nitin710/openplant_incubator_ee/3d/ATX_Connector_24pi_90deg.stp

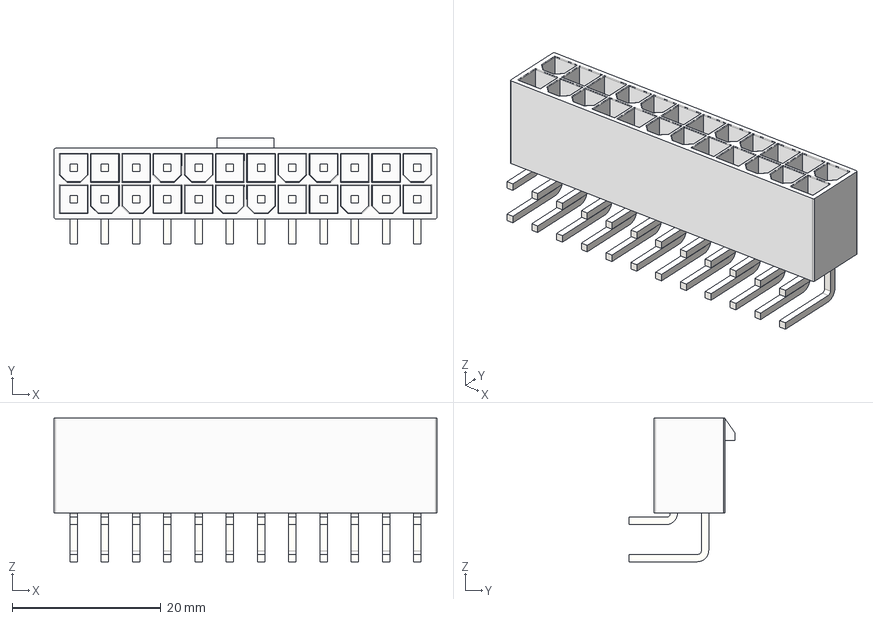
[picture p1: CAD file, 2024-10-21]
3d/ATX_Connector_24pi_90deg.stp
51.5 x 14.3 x 19.3 mm
