nitin710/openplant_incubator_ee/Incubator-PowerBoard.kicad_pcb

## KiCad design Incubator-PowerBoard.kicad_pcb (2024-11-17)

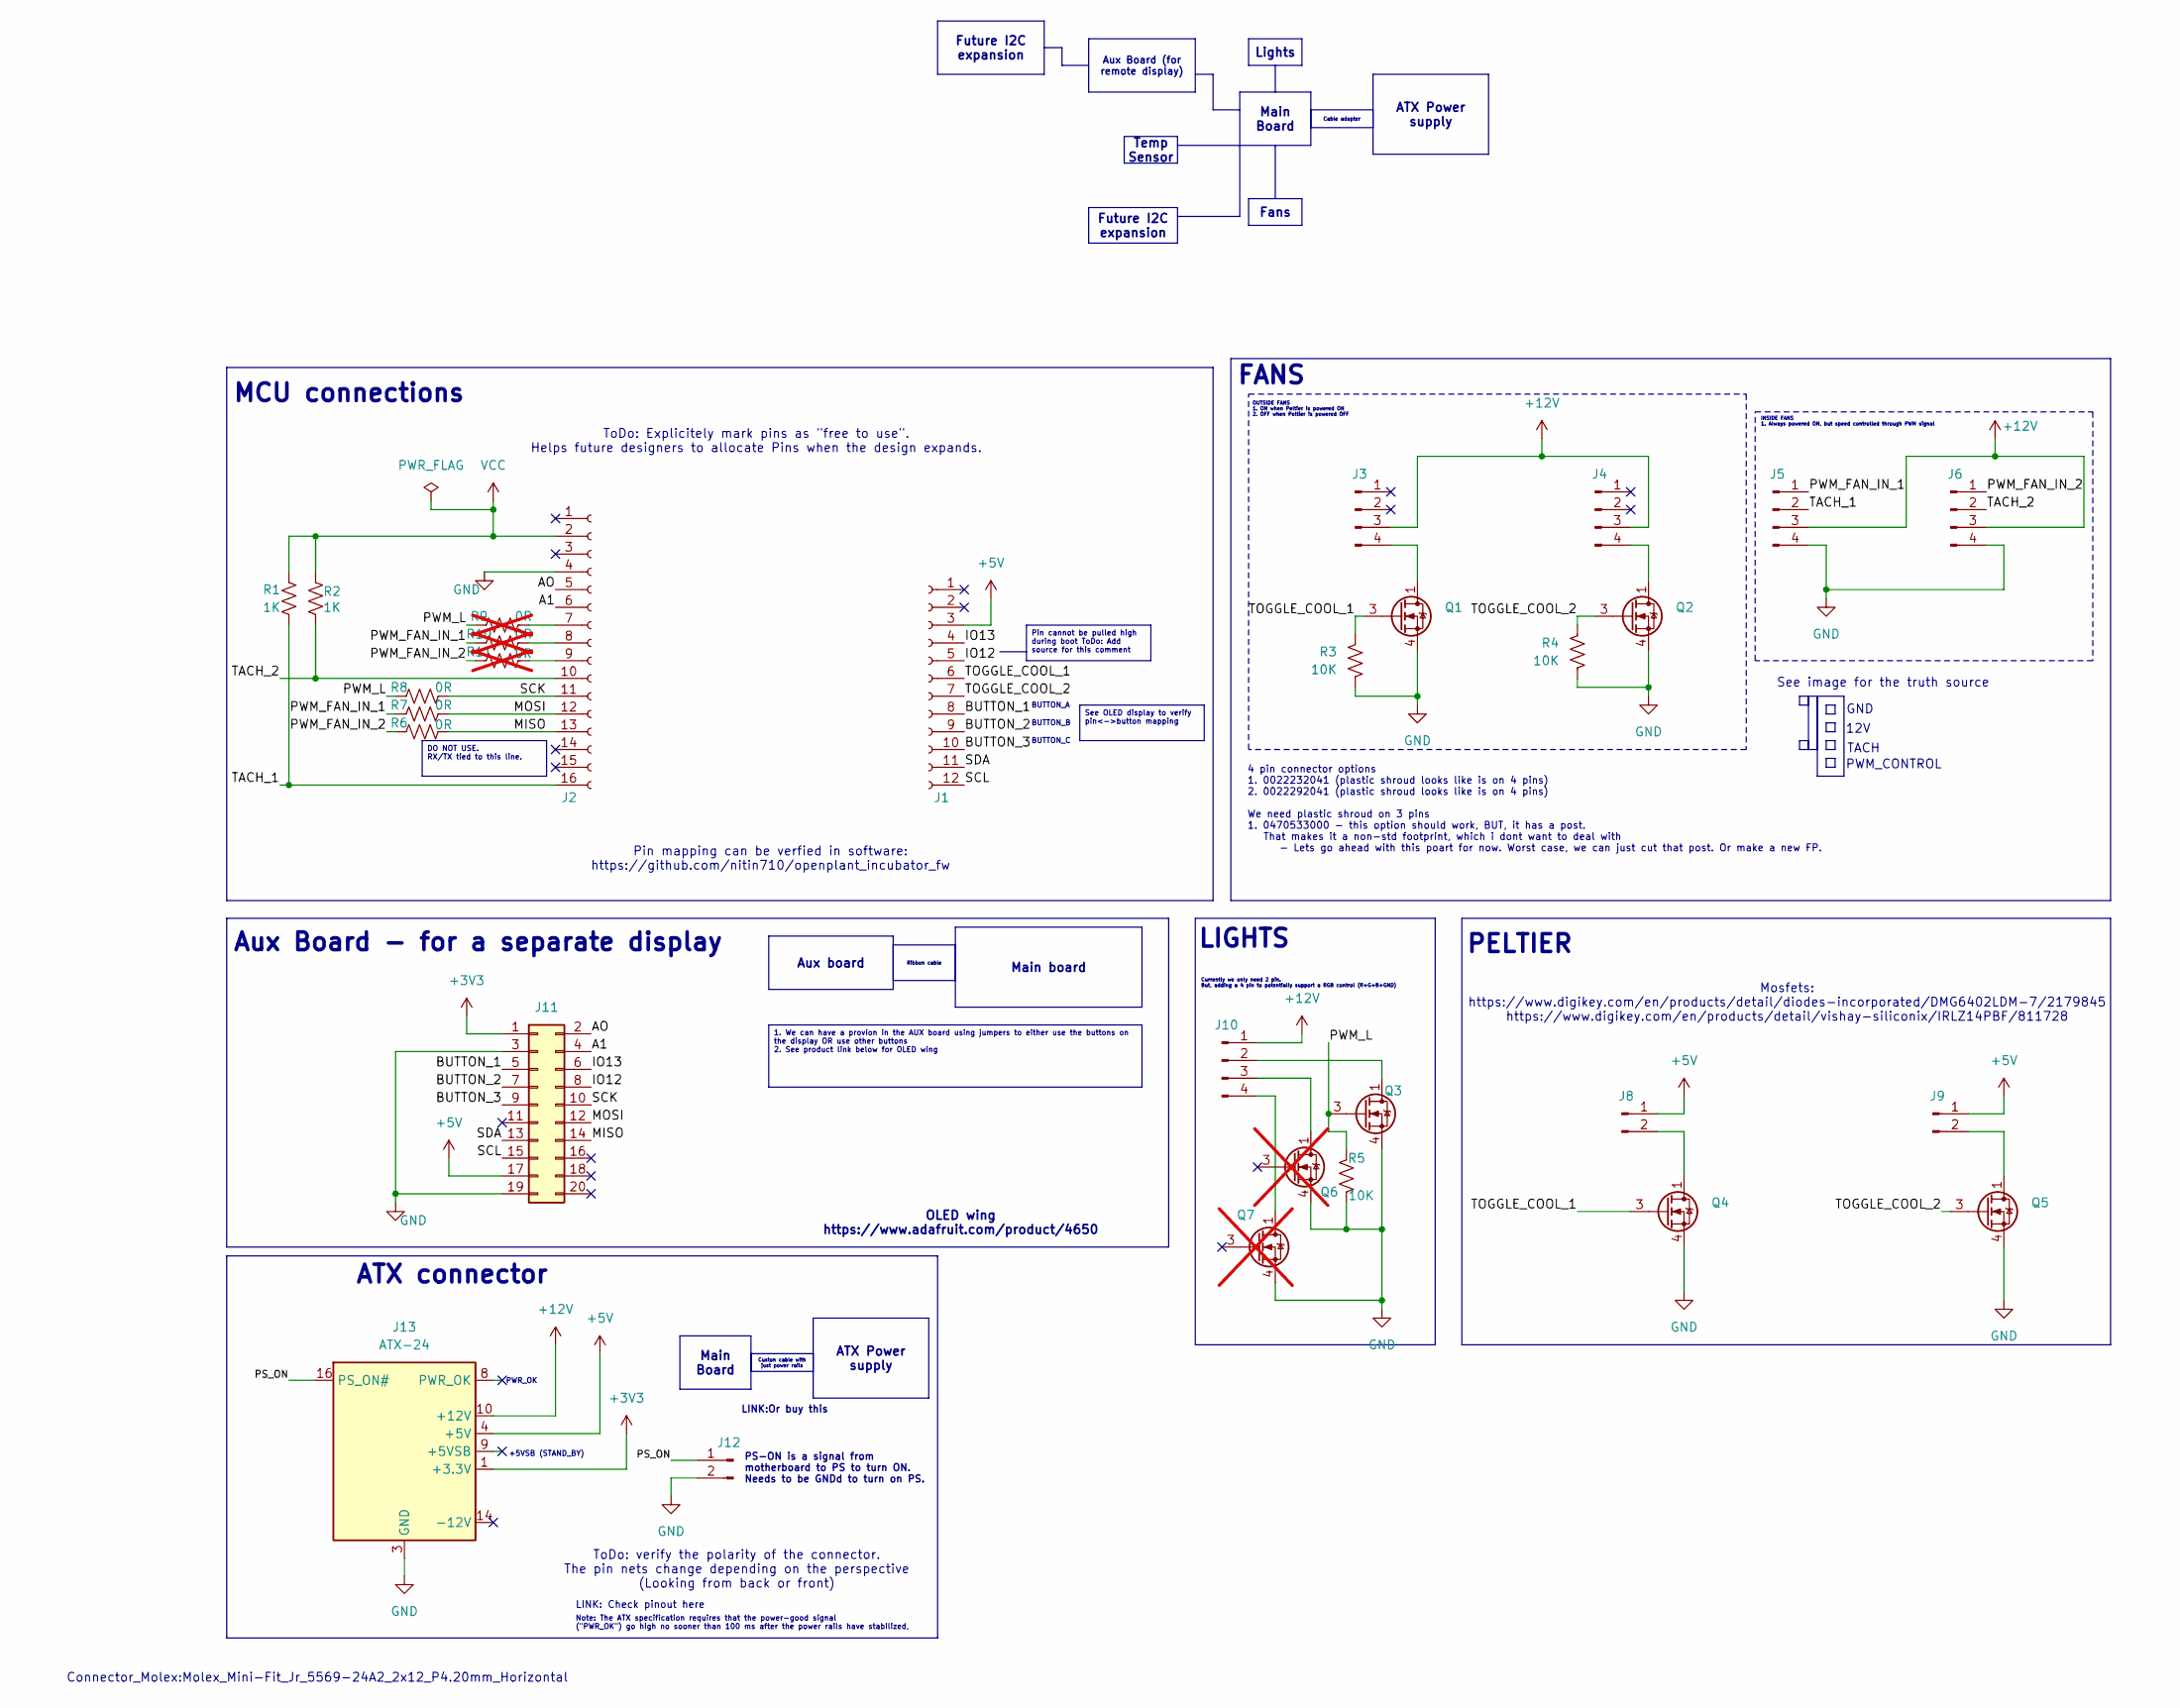
[picture p2: schematic Incubator-PowerBoard.kicad_sch, Openplant Incubator mian board]

Parts:
J1: Conn_01x12_Socket; PinSocket_1x12_P2.54mm_Vertical; MPN PPTC121LFBN-RC; Digikey_Part_Number S6100-ND
J2: Conn_01x16_Socket; PinSocket_1x16_P2.54mm_Vertical; MPN PPTC161LFBN-RC; Digikey_Part_Number S7014-ND
J3: OUT_FAN_1; PinHeader_1x04_P2.54mm_Vertical; MPN 61300411121; Digikey_Part_Number 732-5317-ND
J4: OUT_FAN_2; PinHeader_1x04_P2.54mm_Vertical; MPN 61300411121; Digikey_Part_Number 732-5317-ND
J5: IN_FAN_1; PinHeader_1x04_P2.54mm_Vertical; MPN 61300411121; Digikey_Part_Number 732-5317-ND
J6: IN_FAN_2; PinHeader_1x04_P2.54mm_Vertical; MPN 61300411121; Digikey_Part_Number 732-5317-ND
J8: PELTIER_1; PinHeader_1x02_P2.54mm_Vertical; MPN 61300211121; Digikey_Part_Number 732-5315-ND
J9: PELTIER_2; PinHeader_1x02_P2.54mm_Vertical; MPN 61300211121; Digikey_Part_Number 732-5315-ND
J10: LIGHTS; PinHeader_1x04_P2.54mm_Vertical; MPN 61300411121; Digikey_Part_Number 732-5317-ND
J11: Conn_02x10_Odd_Even; PinHeader_2x10_P2.54mm_Vertical
J12: Conn_01x02_Pin; PinHeader_1x02_P2.54mm_Vertical; MPN 61300211121; Digikey_Part_Number 732-5315-ND
J13: ATX-24; Molex_Mini-Fit_Jr_5569-24A2_2x12_P4.20mm_Horizontal
Q1: OUT_FAN_1; SOT-23-6; MPN DMG6402LVT-7; Digikey_Part_Number DMG6402LVT-7DICT-ND
Q2: OUT_FAN_2; SOT-23-6; MPN DMG6402LVT-7; Digikey_Part_Number DMG6402LVT-7DICT-ND
Q3: LIGHTS; SOT-23-6; MPN DMG6402LVT-7; Digikey_Part_Number DMG6402LVT-7DICT-ND
Q4: PELTIER_1; SOT-23-6; MPN DMG6402LVT-7; Digikey_Part_Number DMG6402LVT-7DICT-ND
Q5: PELTIER_2; SOT-23-6; MPN DMG6402LVT-7; Digikey_Part_Number DMG6402LVT-7DICT-ND
Q6, Q7: DMG6402LVT-7; SOT-23-6; MPN DMG6402LVT-7; Digikey_Part_Number DMG6402LVT-7DICT-ND; not fitted
R1, R2: 1K; R_1210_3225Metric; MPN CRCW12101K00JNEAIF
R3, R4, R5: 10K; R_0603_1608Metric; MPN RMCF0603JT10K0; Digikey_Part_Number RMCF0603JT10K0CT-ND
R6, R7, R8: 0R; R_0603_1608Metric; MPN RMCF0603ZT0R00; Digikey_Part_Number RMCF0603ZT0R00CT-ND
R9, R10, R11: 0R; R_0603_1608Metric; MPN RMCF0603ZT0R00; Digikey_Part_Number RMCF0603ZT0R00CT-ND; not fitted

Connections:
+3V3: J11.1, J13.1 (+3.3V), J13.2 (+3.3V), J13.12 (+3.3V), J13.13 (+3.3V)
+5V: J1.3, J8.1, J9.1, J11.17, J13.4 (+5V), J13.6 (+5V), J13.21 (+5V), J13.22 (+5V), J13.23 (+5V)
+12V: J3.3, J4.3, J5.3, J6.3, J10.1, J13.10 (+12V), J13.11 (+12V)
/A1: J2.6, J11.4
/AO: J2.5, J11.2
/BUTTON_1: J1.8, J11.5
/BUTTON_2: J1.9, J11.7
/BUTTON_3: J1.10, J11.9
/IO12: J1.5, J11.8
/IO13: J1.4, J11.6
/MISO: J2.13, J11.14, R6.2
/MOSI: J2.12, J11.12, R7.2
/PS_ON: J12.1, J13.16 (PS_ON#)
/PWM_FAN_IN_1: J5.1, R7.1, R10.1
/PWM_FAN_IN_2: J6.1, R6.1, R11.1
/PWM_L: Q3.3 (G), R5.1, R8.1, R9.1
/SCK: J2.11, J11.10, R8.2
/SCL: J1.12, J11.15
/SDA: J1.11, J11.13
/TACH_1: J2.16, J5.2, R1.2
/TACH_2: J2.10, J6.2, R2.2
/TOGGLE_COOL_1: J1.6, Q1.3 (G), Q4.3 (G), R3.1
/TOGGLE_COOL_2: J1.7, Q2.3 (G), Q5.3 (G), R4.1
GND: J2.4, J5.4, J6.4, J11.3, J11.19, J12.2, J13.3 (GND), J13.5 (GND), J13.7 (GND), J13.15 (GND), J13.17 (GND), J13.18 (GND), J13.19 (GND), J13.24 (GND), Q1.4 (S), Q2.4 (S), Q3.4 (S), Q4.4 (S), Q5.4 (S), Q6.4 (S), Q7.4 (S), R3.2, R4.2, R5.2
unnamed: J2.7, R9.2
unnamed: J2.8, R10.2
unnamed: J2.9, R11.2
unnamed: J3.4, Q1.1 (D), Q1.2 (D), Q1.5 (D), Q1.6 (D)
unnamed: J4.4, Q2.1 (D), Q2.2 (D), Q2.5 (D), Q2.6 (D)
unnamed: J8.2, Q4.1 (D), Q4.2 (D), Q4.5 (D), Q4.6 (D)
unnamed: J9.2, Q5.1 (D), Q5.2 (D), Q5.5 (D), Q5.6 (D)
unnamed: J10.2, Q3.1 (D), Q3.2 (D), Q3.5 (D), Q3.6 (D)
unnamed: J10.3, Q6.1 (D), Q6.2 (D), Q6.5 (D), Q6.6 (D)
unnamed: J10.4, Q7.1 (D), Q7.2 (D), Q7.5 (D), Q7.6 (D)
VCC: J2.2, R1.1, R2.1

Notes on the sheet:
Aux Board (for remote display)
Fans
ATX Power supply
DO NOT USE. RX/TX tied to this line.
See OLED display to verify pin<->button mapping
Main board
Cable adapter
Pin cannot be pulled high during boot ToDo: Add source for this comment
Lights
Future I2C expansion
Main Board
1. We can have a provion in the AUX board using jumpers to either use the buttons on the display OR use other buttons 2. See product link below for OLED wing
Ribbon cable
Custon cable with just power rails
Temp Sensor
Aux board
PELTIER
PWM_CONTROL
LINK:Or buy this
BUTTON_B
See image for the truth source
Aux Board - for a separate display
MCU connections
LINK: Check pinout here
4 pin connector options 1. 0022232041 (plastic shroud looks like is on 4 pins) 2. 0022292041 (plastic shroud looks like is on 4 pins) We need plastic shroud on 3 pins 1. 0470533000 - this option should work, BUT, it has a post. That makes it a non-std footprint, which i dont want to deal with - Let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
GND
Mosfets: https://www.digikey.com/en/products/detail/diodes-incorporated/DMG6402LDM-7/2179845 https://www.digikey.com/en/products/detail/vishay-siliconix/IRLZ14PBF/811728
BUTTON_C
ToDo: Explicitely mark pins as "free to use". Helps future designers to allocate Pins when the design expands.
OUTSIDE FANS 1. ON when Peltier is powered ON 2. OFF when Peltier is powered OFF
OLED wing https://www.adafruit.com/product/4650
Currently we only need 2 pin. But, adding a 4 pin to potentially support a RGB control (R+G+B+GND)
ATX connector
INSIDE FANS 1. Always powered ON, but speed controlled through PWM signal
Pin mapping can be verfied in software: https://github.com/nitin710/openplant_incubator_fw
ToDo: verify the polarity of the connector. The pin nets change depending on the perspective (Looking from back or front)
LIGHTS
+5VSB (STAND_BY)
BUTTON_A
FANS
12V
PWR_OK
TACH
Connector_Molex:Molex_Mini-Fit_Jr_5569-24A2_2x12_P4.20mm_Horizontal
Note: The ATX specification requires that the power-good signal ("PWR_OK") go high no sooner than 100 ms after the power rails have stabilized,
PS-ON is a signal from motherboard to PS to turn ON. Needs to be GNDd to turn on PS.

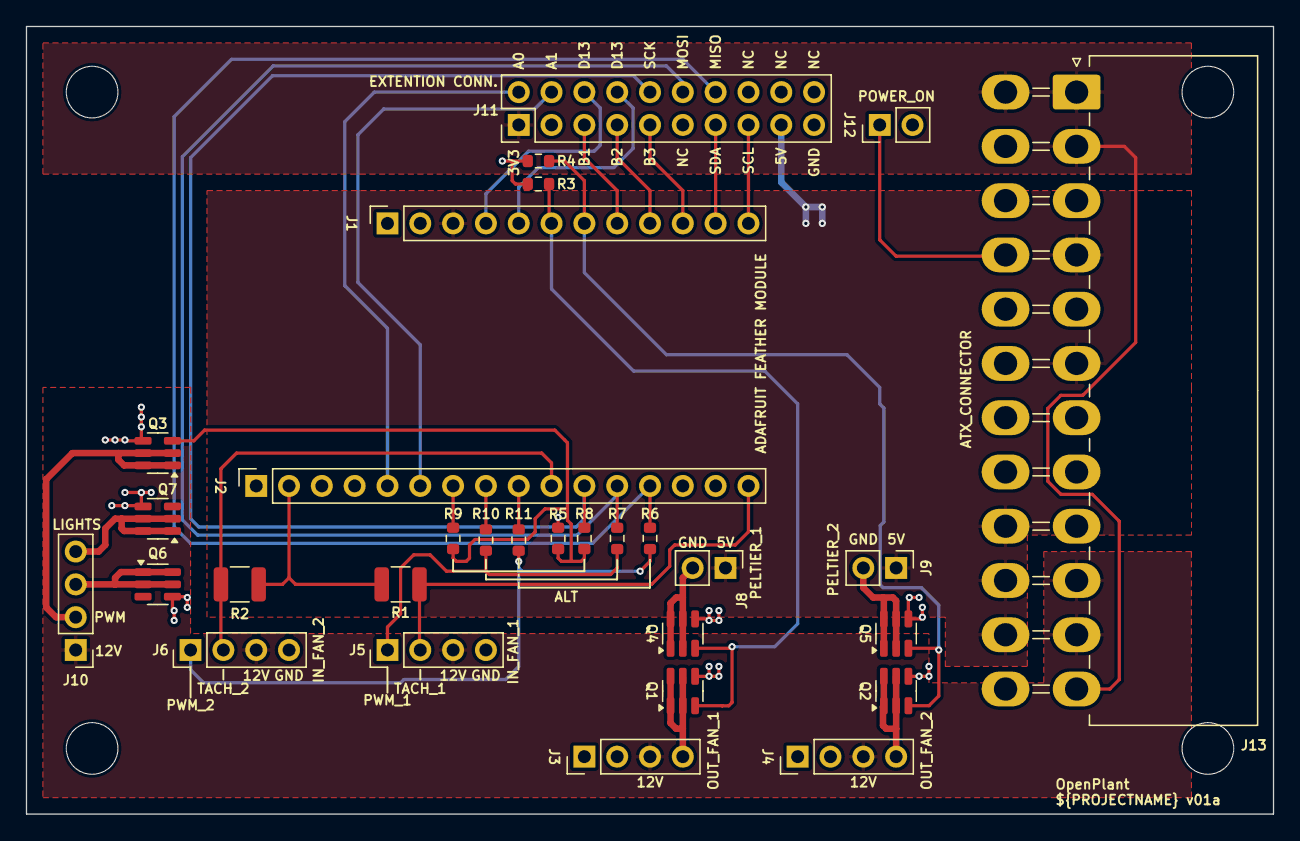
[picture p3: board Incubator-PowerBoard.kicad_pcb from above]

Board: 2 copper layers, 96.5 x 61.0 mm, 30 parts (0 on the bottom side), 35 nets.
