nitin710/openplant_incubator_ee/(commit log)

2024-03-04 adding init design files
    [Incubator-PowerBoard.kicad_pcb, Incubator-PowerBoard.kicad_sch]
2024-03-04 udpated comments
    [Incubator-PowerBoard.kicad_sch]
2024-10-19 layout complete
    [Incubator-PowerBoard.kicad_pcb, Incubator-PowerBoard.kicad_sch]
2024-10-21 added 3d for atx connector
    [ATX_Connector_24pi_90deg.stp, Incubator-PowerBoard.kicad_pcb]
2024-11-17 adding MFG files
    [Incubator-PowerBoard-B_Cu.gbl, Incubator-PowerBoard-B_Fab.gbr, Incubator-PowerBoard-B_Mask.gbs, Incubator-PowerBoard-B_Paste.gbp, Incubator-PowerBoard-B_Silkscreen.gbo, Incubator-PowerBoard-Edge_Cuts.gm1, Incubator-PowerBoard-F_Cu.gtl, Incubator-PowerBoard-F_Fab.gbr]
